bedrockskeleton/blind-iron/Print Files/Dial Spindel.stl

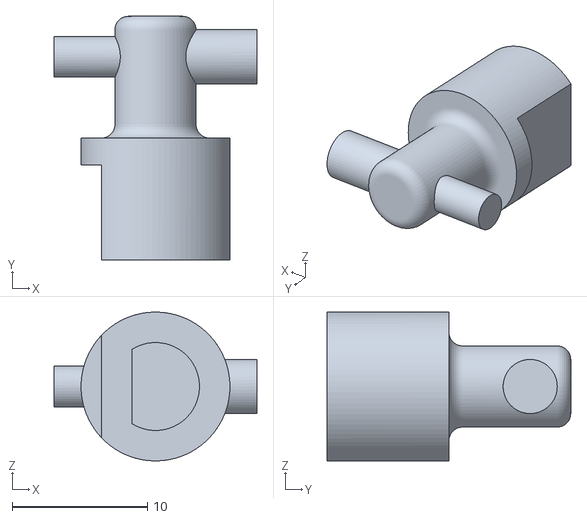
[picture p1: CAD file, 2024-05-15]
Print Files/Dial Spindel.stl
15.0 x 18.0 x 11.0
