bedrockskeleton/blind-iron/Print Files/Backing.stl

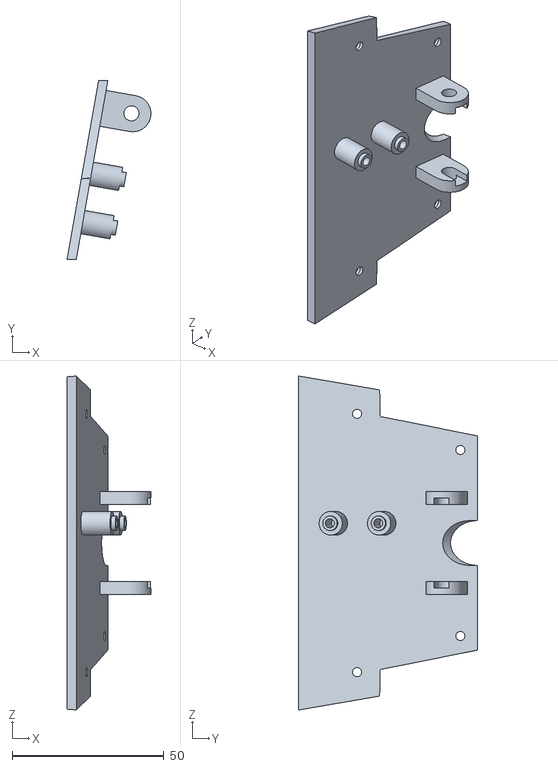
[picture p2: CAD file, 2024-05-15]
Print Files/Backing.stl
27.7 x 59.0 x 110.1
