bedrockskeleton/blind-iron/Print Files/Shell.stl

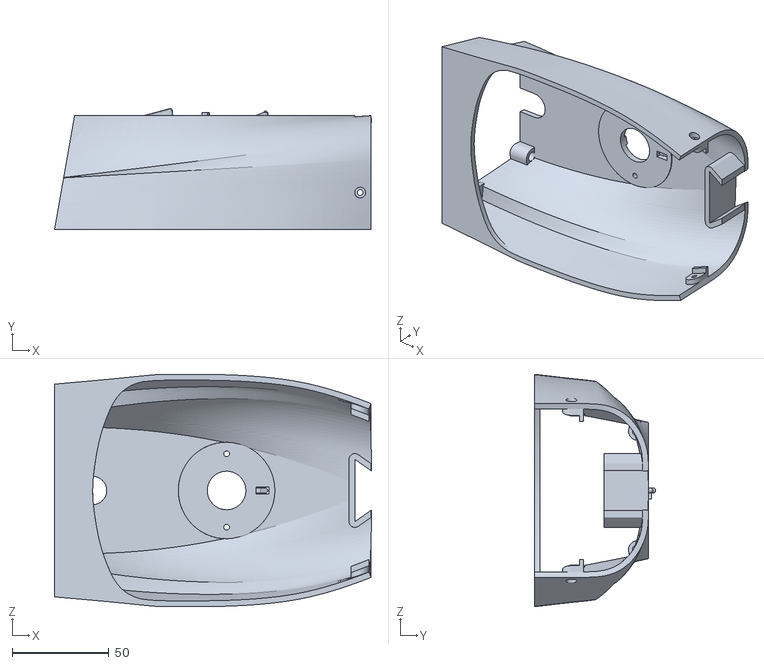
[picture p3: CAD file, 2024-05-15]
Print Files/Shell.stl
164.2 x 62.7 x 120.4
