bedrockskeleton/blind-iron/Print Files/Dial Label.stl

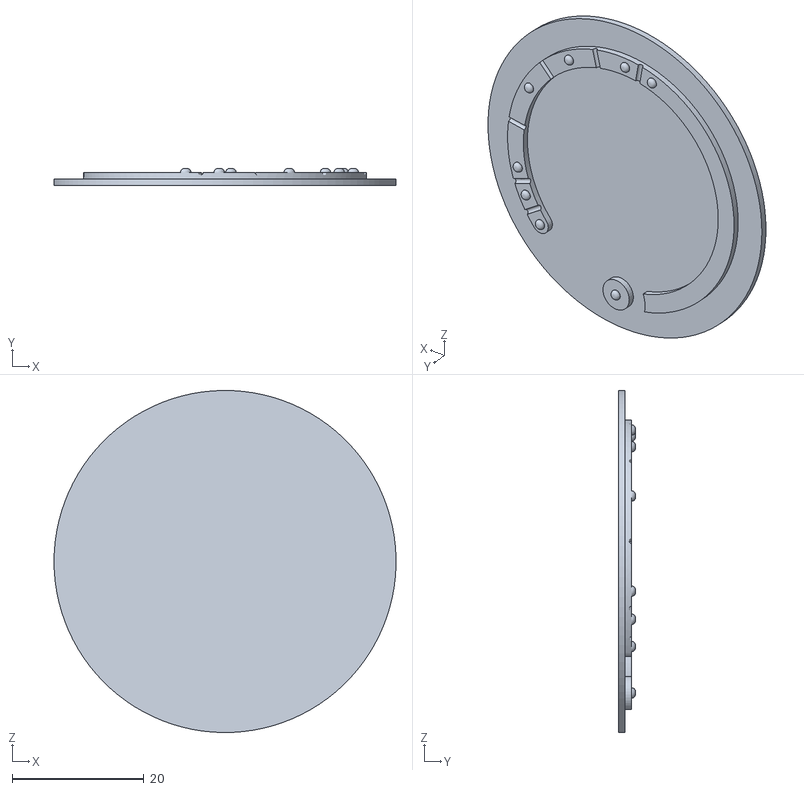
[picture p4: CAD file, 2024-05-15]
Print Files/Dial Label.stl
52.0 x 2.60 x 52.0
