bedrockskeleton/blind-iron/Print Files/Test Fit.stl

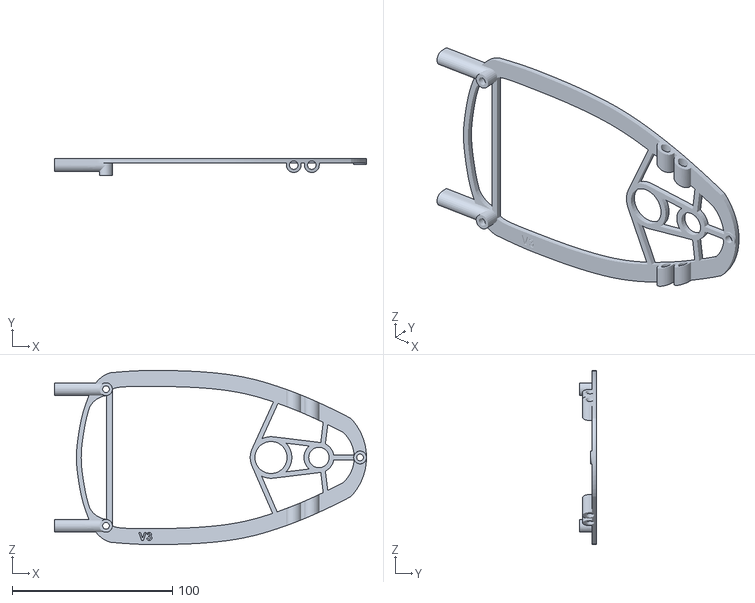
[picture p5: CAD file, 2024-05-15]
Print Files/Test Fit.stl
194.6 x 10.7 x 108.6
