bedrockskeleton/blind-iron/(list of files, cad)

Other CAD files:
Design Files/Braille Components.f3d
