bedrockskeleton/blind-iron/(commit log)

2024-05-15 Adding print files
    [Backing.stl, Dial Label.stl, Dial Spindel.stl, Grip.stl, Shell.stl, Test Fit.stl]
2024-05-15 Rename Backing.stl to Print Files/Backing.stl
    [Backing.stl]
2024-05-15 Rename Dial Label.stl to Print Files/Dial Label.stl
    [Dial Label.stl]
2024-05-15 Rename Dial Spindel.stl to Print Files/Dial Spindel.stl
    [Dial Spindel.stl]
2024-05-15 Rename Grip.stl to Print Files/Grip.stl
    [Grip.stl]
2024-05-15 Rename Shell.stl to Print Files/Shell.stl
    [Shell.stl]
2024-05-15 Rename Test Fit.stl to Print Files/Test Fit.stl
    [Test Fit.stl]
2024-05-15 Rename Blind Iron.f3z to Design Files/Blind Iron.f3z
    [Blind Iron.f3z]
2024-05-15 Rename Braille Components.f3d to Design Files/Braille Components.f3d
    [Braille Components.f3d]
